sideburn/WatchmanPongV2/Hardware Mods/RFModulePrep.jpeg

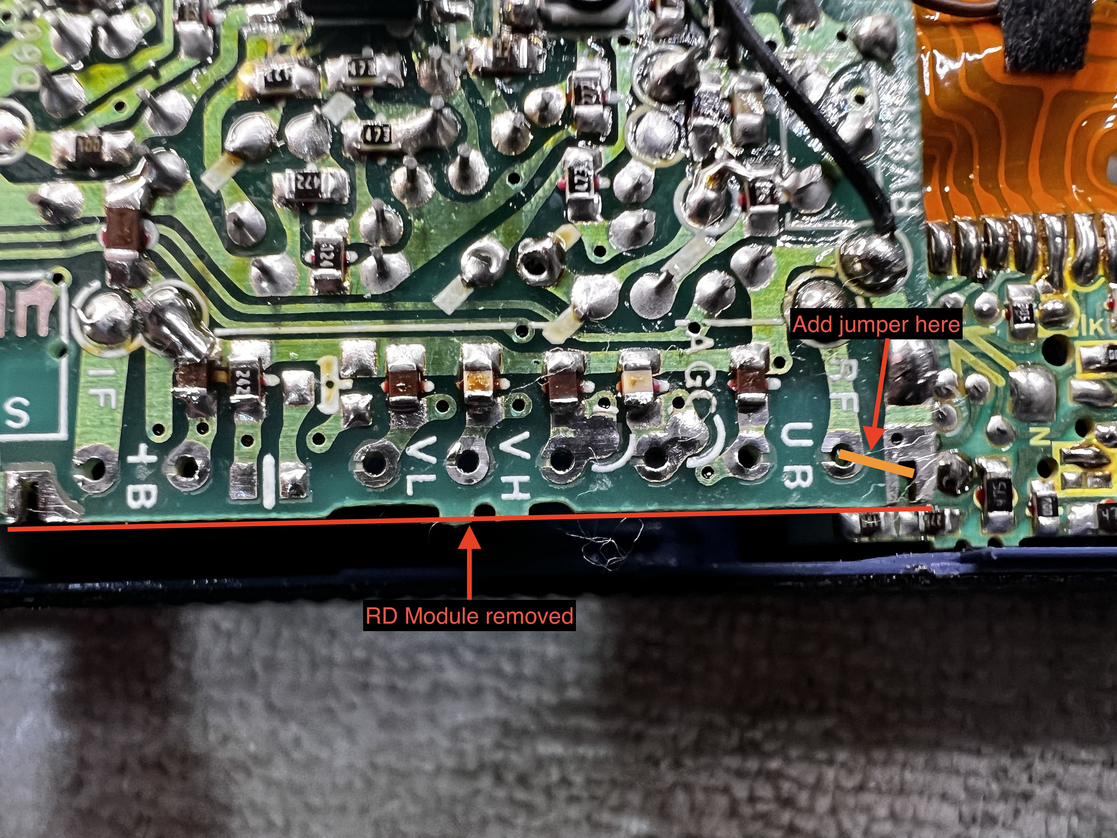
Hardware Mods/RFModulePrep.jpeg
