sideburn/WatchmanPongV2/Hardware Mods/wiring.jpeg

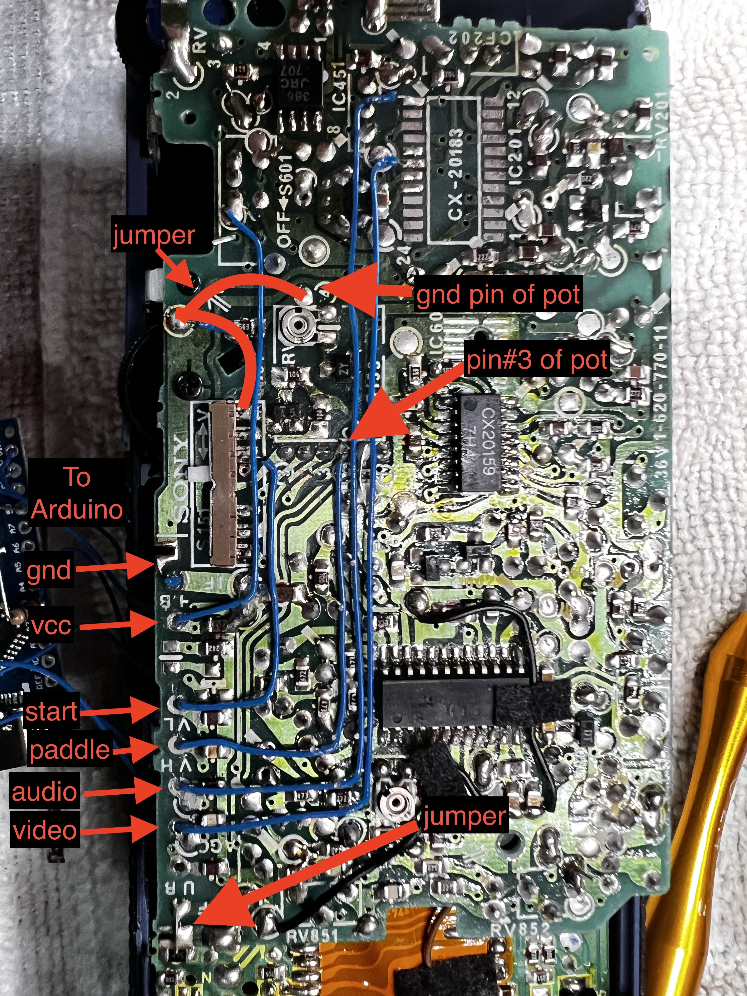
Hardware Mods/wiring.jpeg
