sideburn/WatchmanPongV2/Hardware Mods/arduino.jpeg

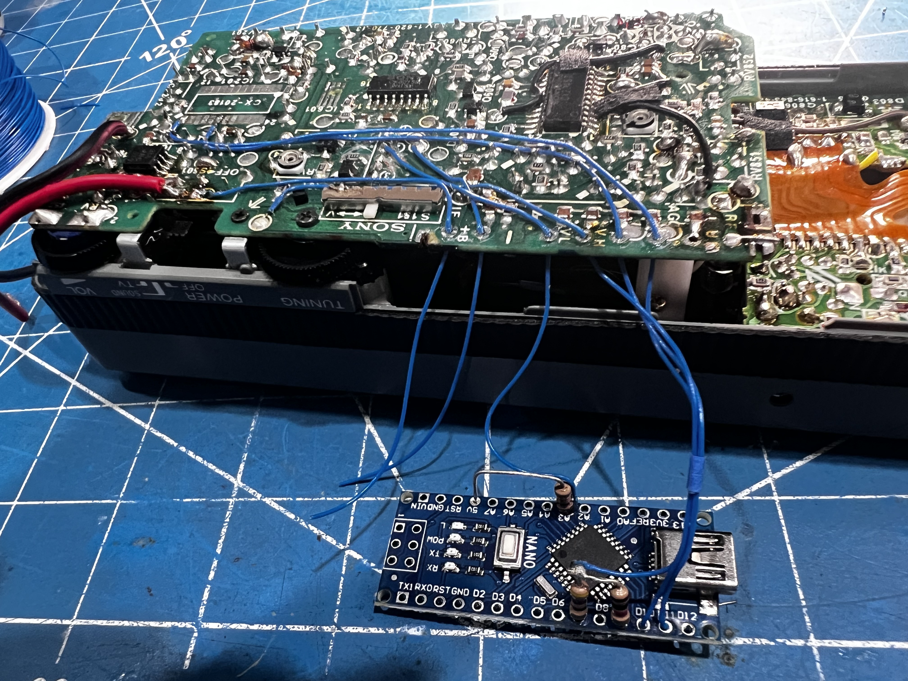
Hardware Mods/arduino.jpeg
