sideburn/WatchmanPongV2/Hardware Mods/avInputs.jpeg

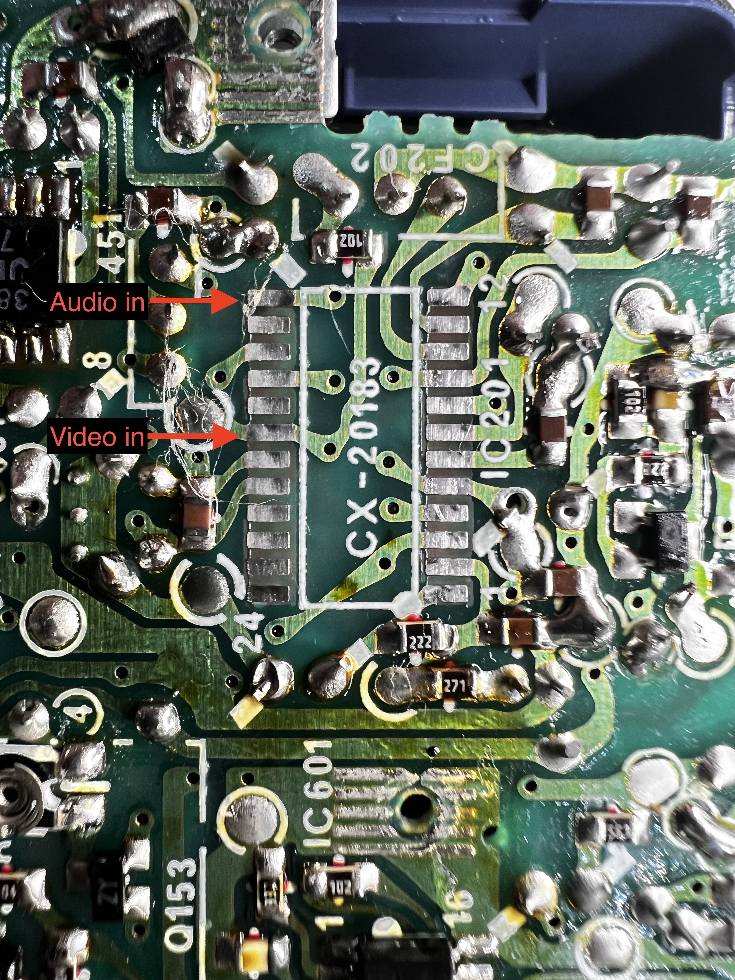
Hardware Mods/avInputs.jpeg
