sideburn/WatchmanPongV2/Hardware Mods/potPrep.jpeg

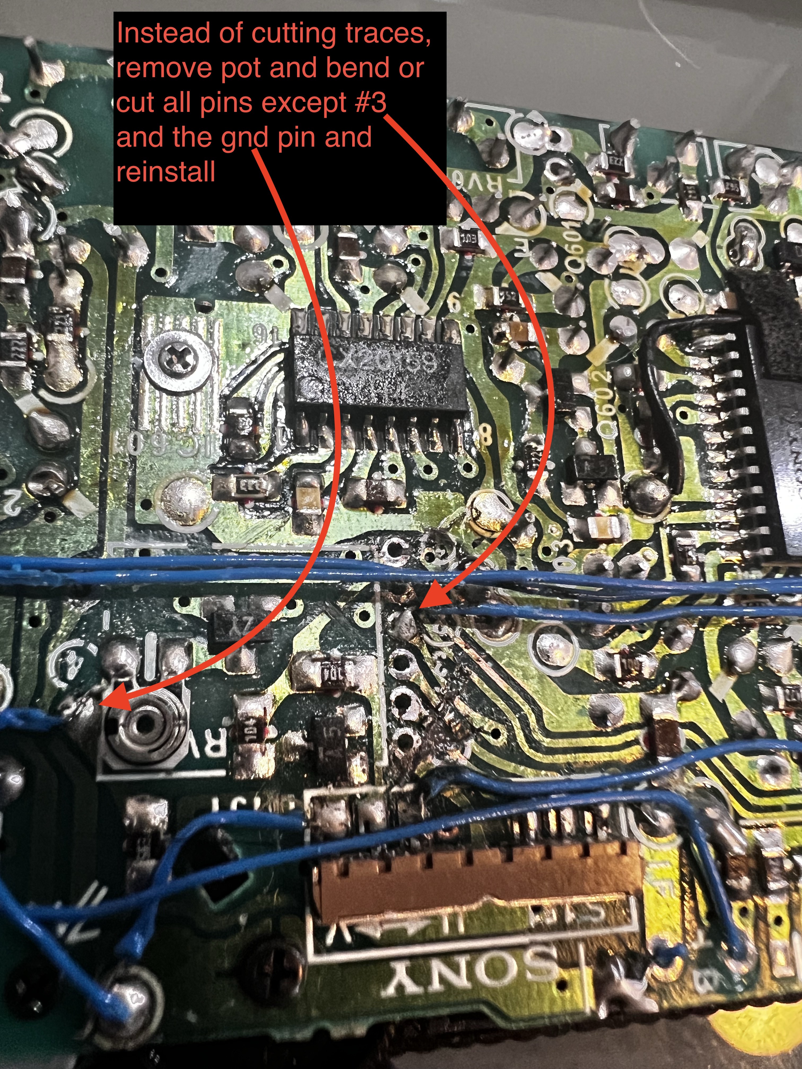
Hardware Mods/potPrep.jpeg
