sideburn/WatchmanPongV2/Hardware Mods/rfModulator.png

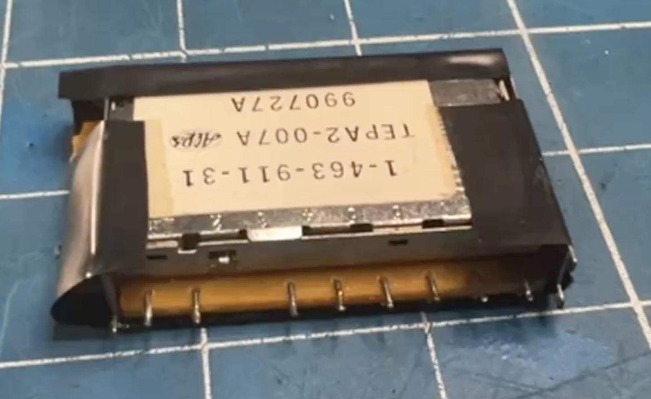
Hardware Mods/rfModulator.png
