sideburn/WatchmanPongV2/Hardware Mods/switchPrep.jpeg

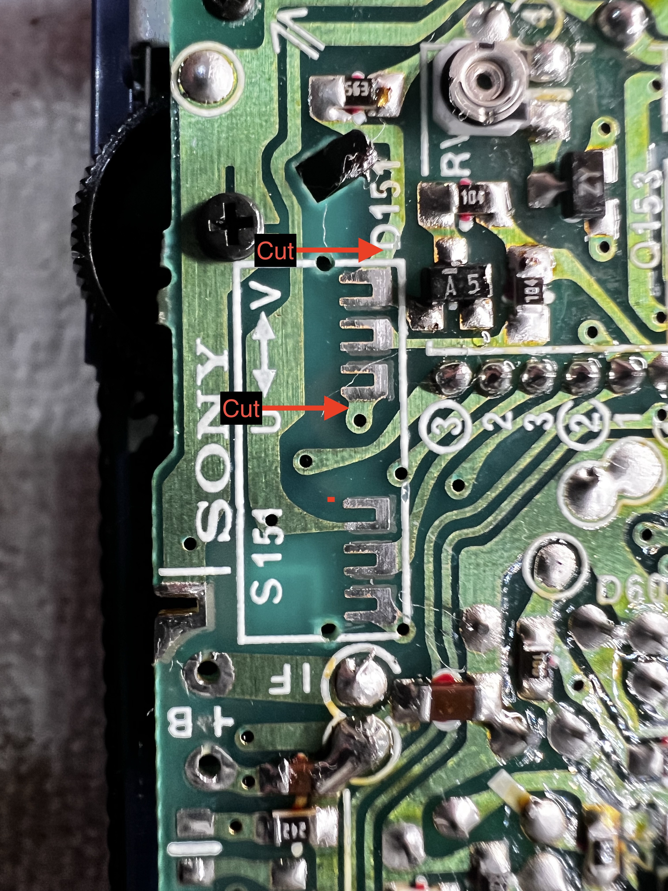
Hardware Mods/switchPrep.jpeg
