sideburn/WatchmanPongV2/Hardware Mods/videoDecoder.png

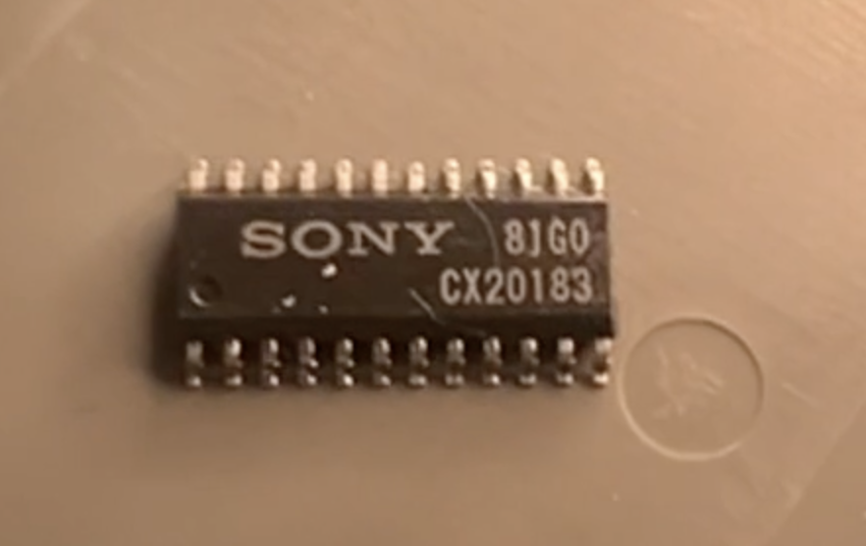
Hardware Mods/videoDecoder.png
