sideburn/WatchmanPongV2/Hardware Mods/componentsToRemove.jpeg

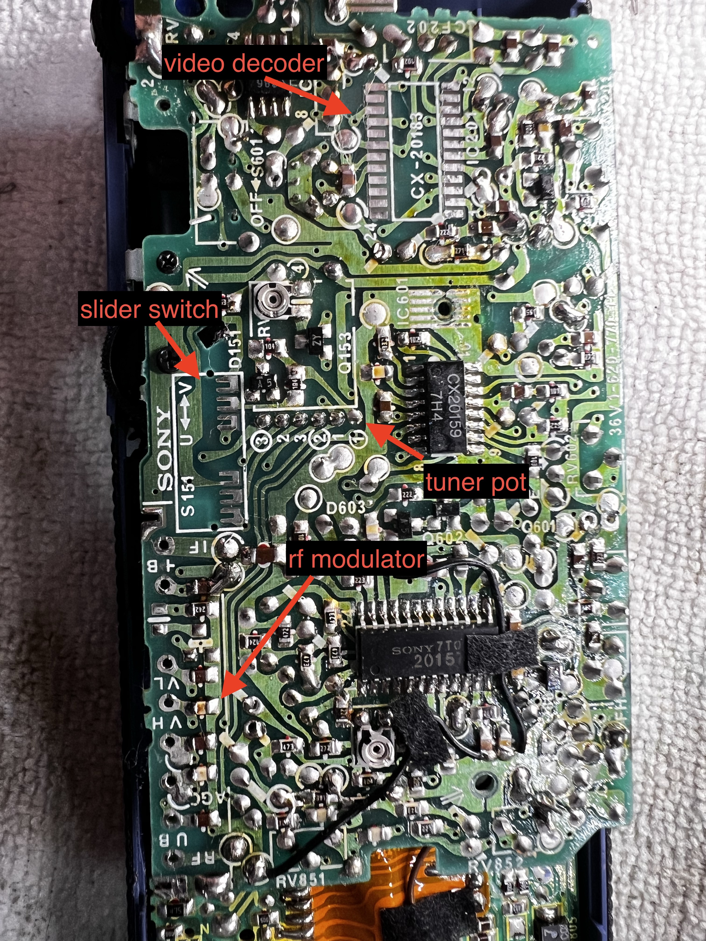
Hardware Mods/componentsToRemove.jpeg
