sideburn/WatchmanPongV2/Assets/pongInstructions/pongInstructions 2.png

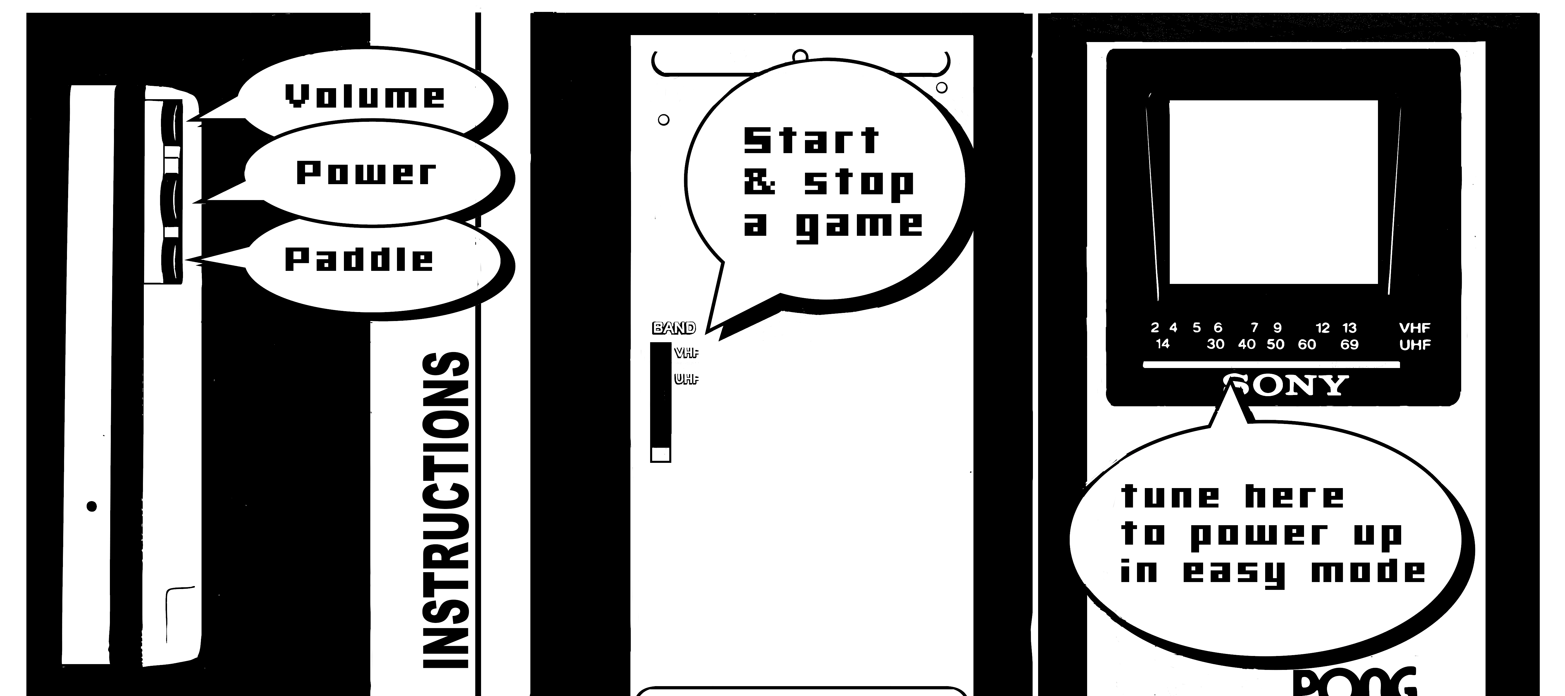
Assets/pongInstructions/pongInstructions 2.png
