sideburn/WatchmanPongV2/Assets/pongInstructions/pongInstructions.png

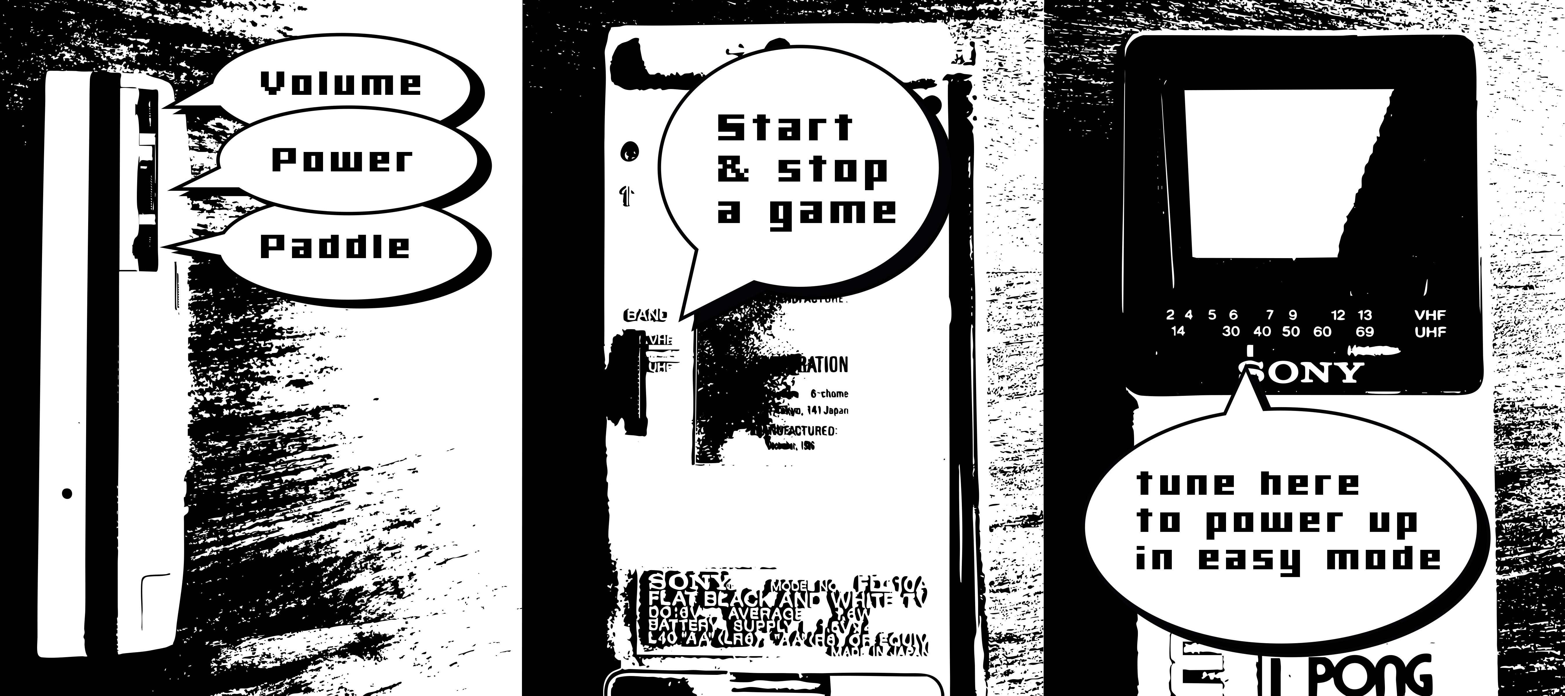
Assets/pongInstructions/pongInstructions.png
