sideburn/WatchmanPongV2/(commit log)

2025-08-26 Fixed angle algoithim so center hits go horizontal only.
    [WatchmanPongV2.ino]
2025-08-26 Added MAX_SCORE setting, removed the middle area hit targeting strategy. replaced the random error with my original settings.
    [WatchmanPongV2.ino]
2025-08-26 Top and bottom boundary fix so we don't get stuck in a horizontal loop.
    [WatchmanPongV2.ino]
2025-08-27 Anti infinite rally fix when paddles are at vertical boundaries
    [WatchmanPongV2.ino]
2025-08-28 fixed missing pixels in 3,8,9 digits, removed seerifs in 1 digit. changed auto start to off.
    [WatchmanPongV2.ino]
2025-08-28 improved ball / scoreboard drawing routines, disabled auto game start on power up.
2025-08-28 Added adjustable paddle sensitivity param and adjusted it so not as jittery.
    [WatchmanPongV2.ino]
2025-08-30 Added adjustable paddle size, updated paddle sensitivity, collision detection and game sounds.
    [WatchmanPongV2.ino]
2025-09-02 Added completed wire work photo.
2025-09-06 Added Easy Mode when tuning to channel 40 on power up.
2025-09-10 Adjustments for POT wiring changes.
